kkatano/bakeneko-65/(notices)

Notices in the files:
pcb/matrix.sch:
Copyright © 2020 kkatano
MIT License
